milton-stark/Hardware-adapter-between-Arduino-and-Lego-components/PCB Schematic.pdf

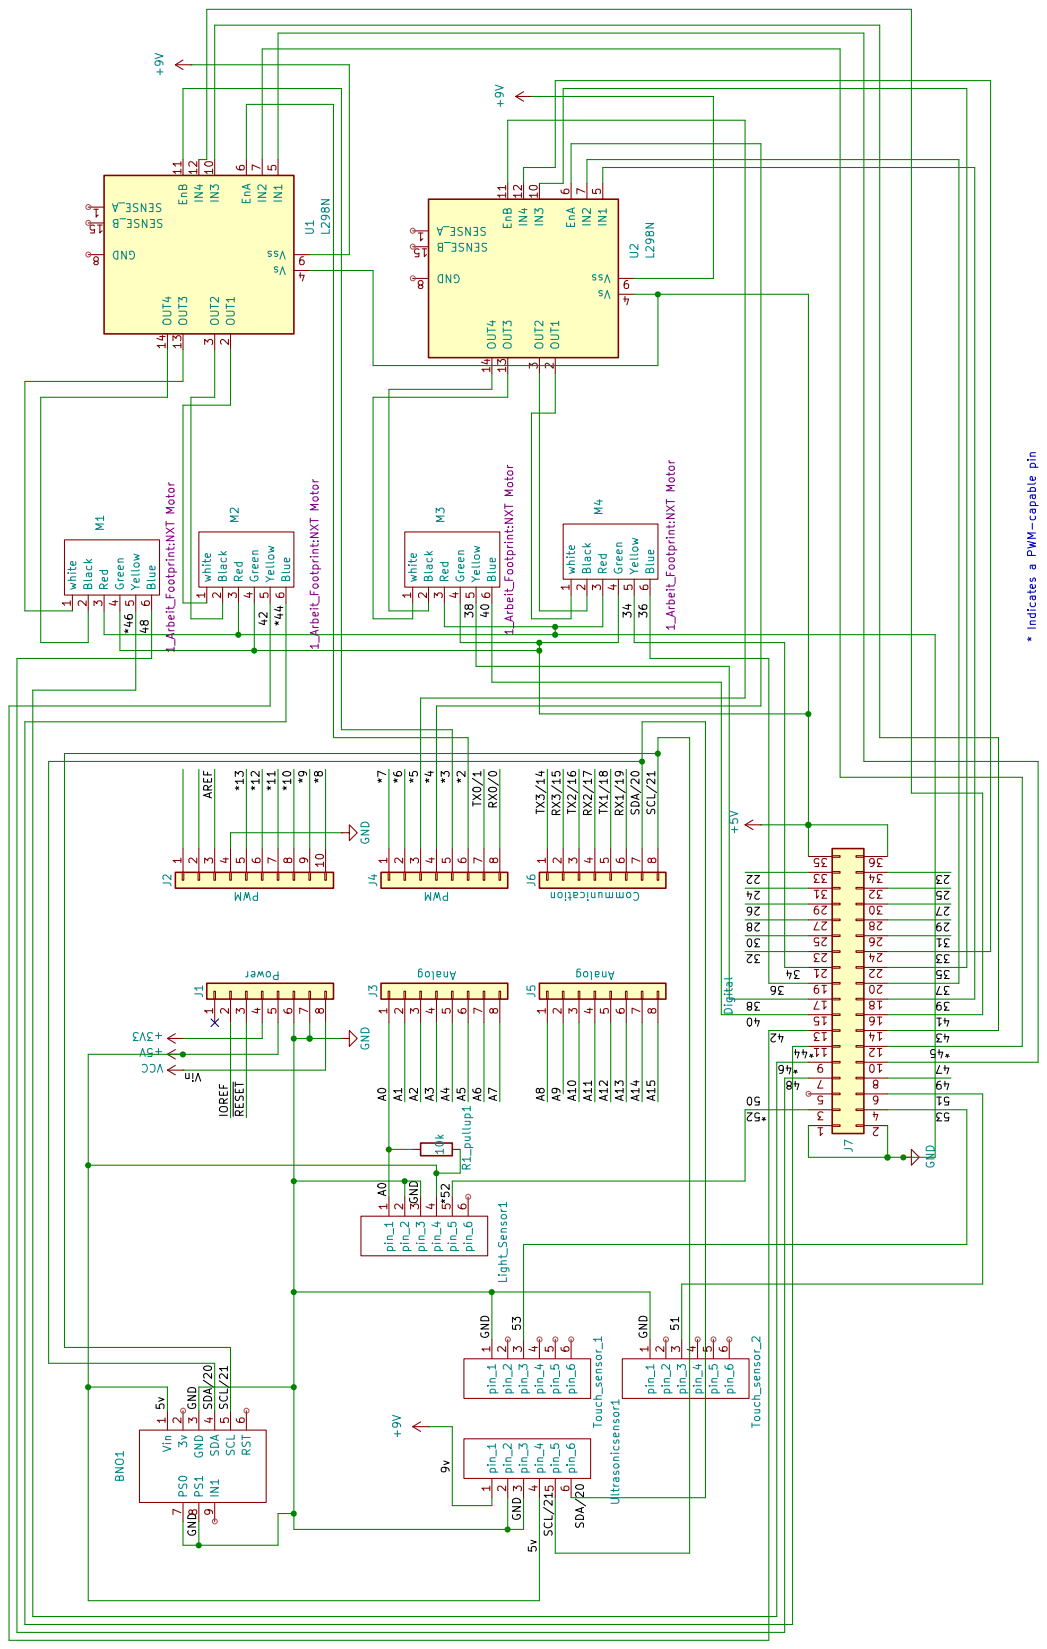
[picture p33: page 1]
