milton-stark/Hardware-adapter-between-Arduino-and-Lego-components/PCB design.pdf

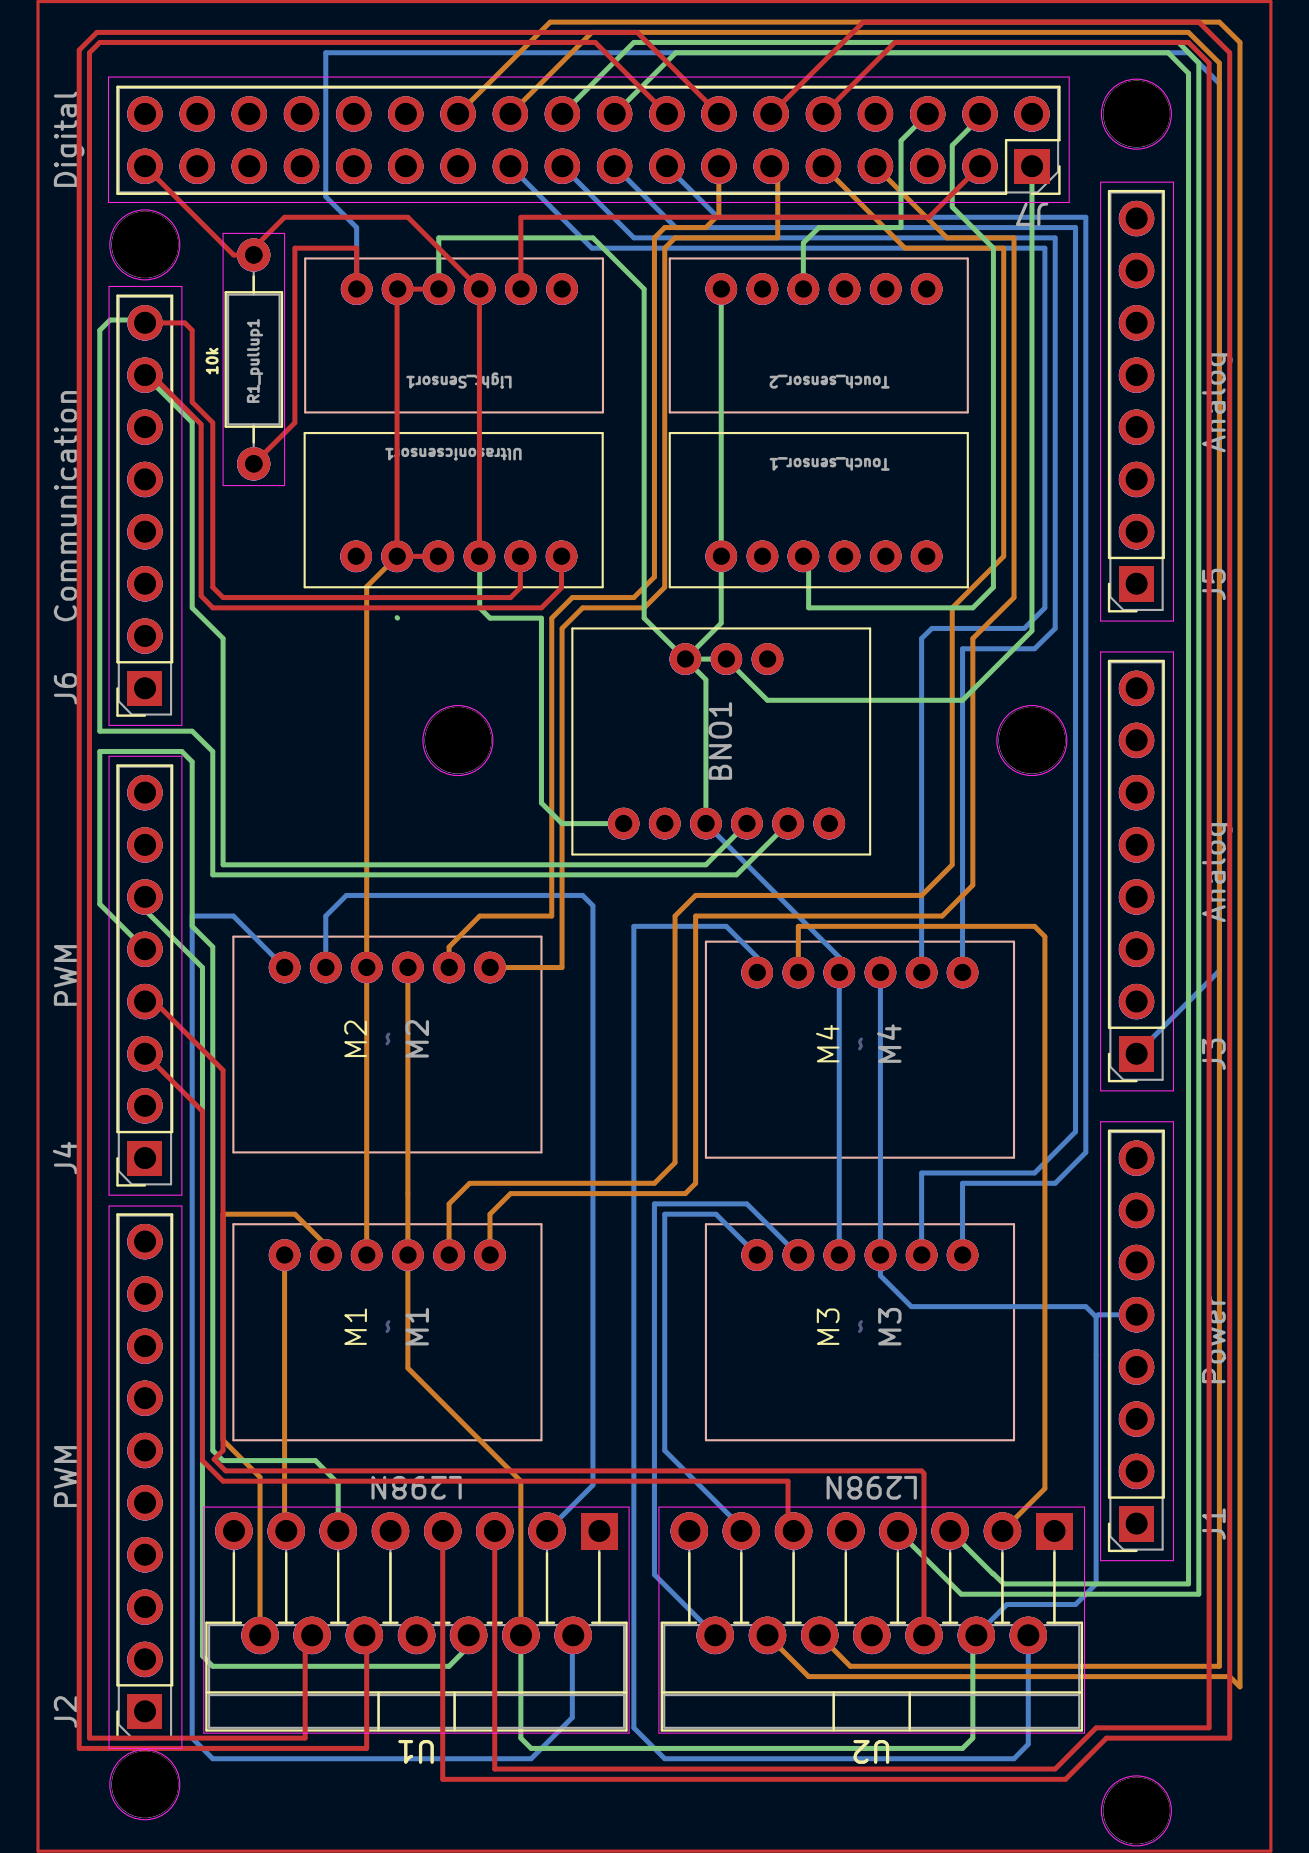
[picture p34: page 1]
