milton-stark/Hardware-adapter-between-Arduino-and-Lego-components/LEGO MINDSTORMS EV3 Hardware Developer Kit/3. Appendix LEGO MINDSTORMS EV3 touch sensor hardware schematics.pdf

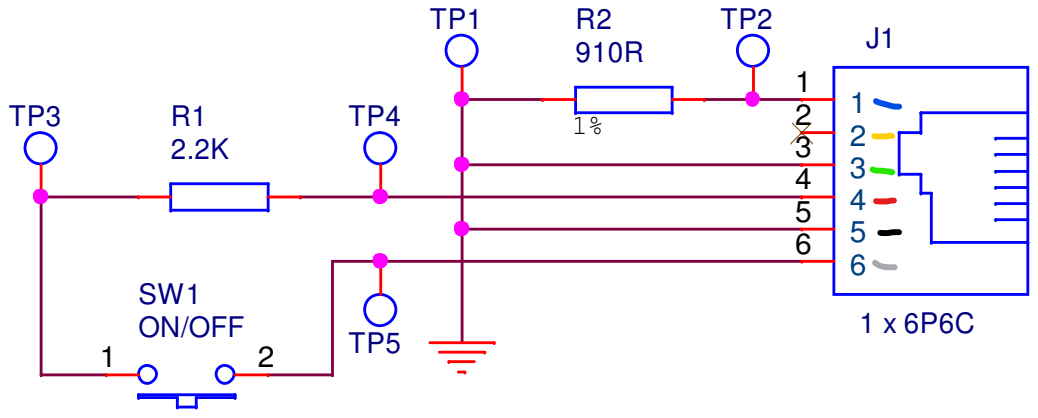
[picture p35: page 1]

Date (YYYY/MM/DD)
