milton-stark/Hardware-adapter-between-Arduino-and-Lego-components/(commit log)

2026-08-29 Preview of the PCB design
2026-08-29 Schematic Preview
2026-08-29 Project files of the PCB layout and Design
2026-08-29 LEGO components Schematics
2026-08-29 Add README for Arduino-LEGO Adapter Shield project
    This README provides an overview of the Arduino ↔ LEGO Hardware Adapter Shield project, detailing its purpose, components, demo firmware, and instructions for getting started.
2026-08-29 Add test case section to README
    Added test case section detailing the validation of the board and firmware on a mobile robot, including setup and testing outcomes.
2026-10-05 Modify README to specify four-wheeled robot
    Updated the description to reflect the change from a two-wheeled to a four-wheeled robot.
